Technische-Natuurkunde-HvA/inverted-pendulum-international-team-5/Visuals/presentation int 5.pdf

### INVERTED PENDULUM

INTERNATIONAL TEAM 5

### SETBACKS

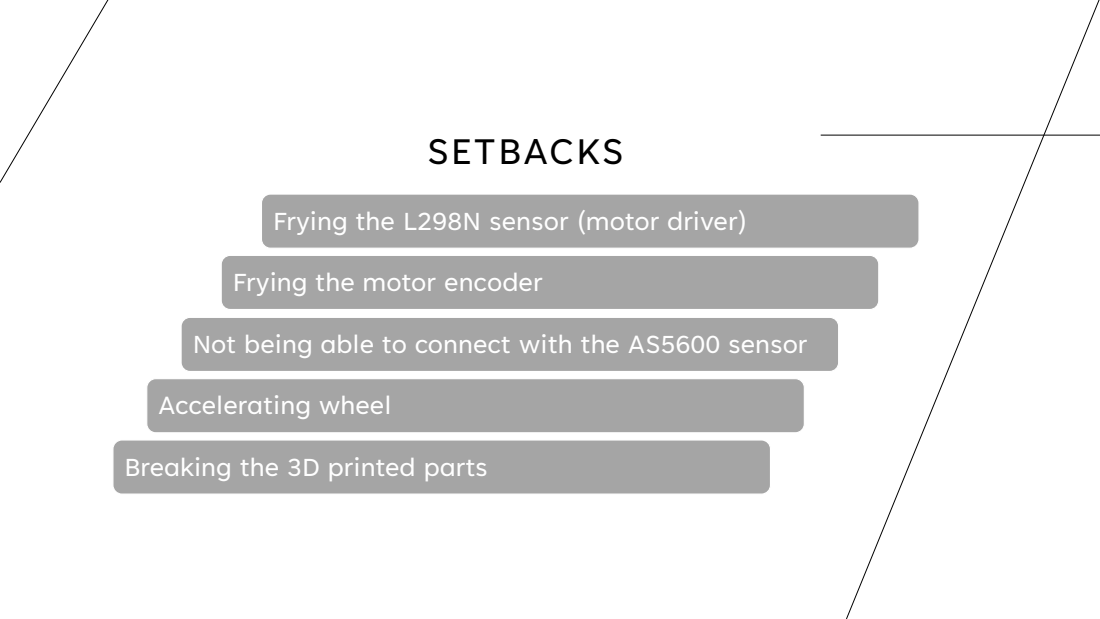
[picture p1: page 2]
Accelerating wheel

Frying the L298N sensor (motor driver)

Frying the motor encoder

Not being able to connect with the AS5600 sensor

Breaking the 3D printed parts

WORK PERFORMED

- Caracterize the motor troque–speed curve
- Implementing a code to print the angle
- Stabilising with the iron bearings
- Stabilize the pendulum with 1 PID ( angle )
- Stabilize the pendulum with a second PID ( speed )
- Printing the results

CURVES AND GRAPHS

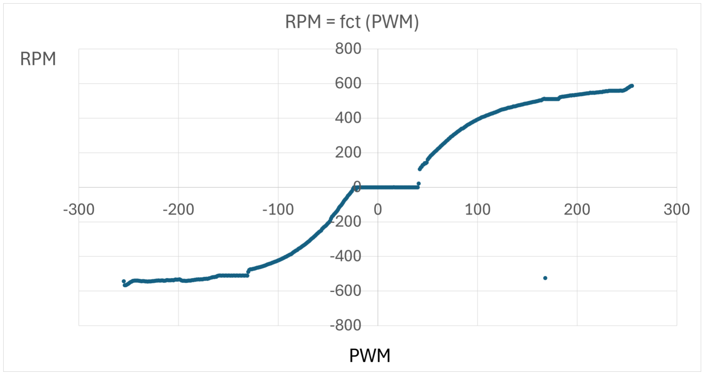
[picture p2: figure]

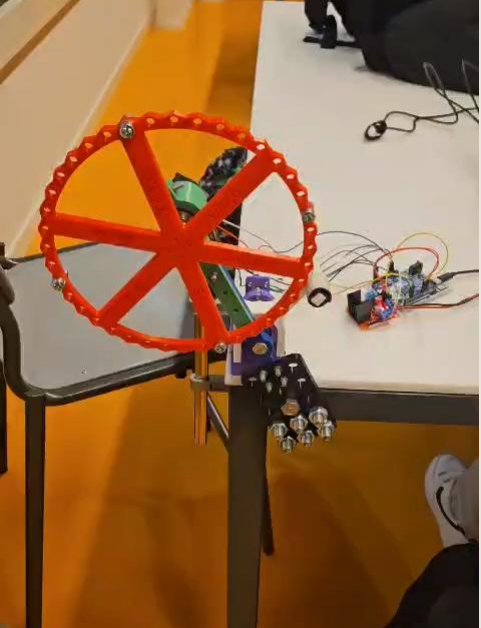
[picture p3: figure]

ACCOMPLISHMENTS

❖ Stabilised with the dummy bearings

❖ Partially stabilised with the second PID-controller and iron bearings

NEXT OBJECTIVE

Second PID to control the wheel’s speed PID tuning strategy :
- Start with P only (Ki = Kd = 0)
- Increase Kp until the response becomes fast with a small overshoot.
- If the response is too slow → increase Kp.
- Add integral action
- Increase Ki to remove steady-state error.
- If oscillations grow or the system becomes unstable → decrease Ki.
- Add derivative action
- Increase Kd to damp oscillations and reduce overshoot.
- If the control becomes noisy → decrease Kd.

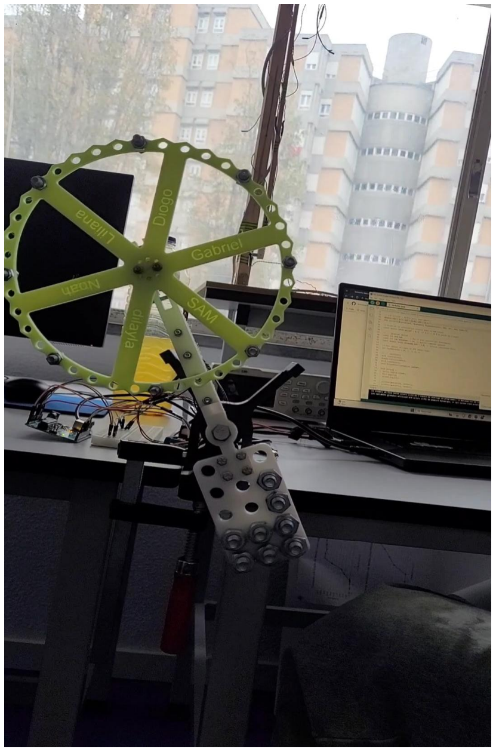
[picture p4: figure]

ACCOMPLISHMENT

- Stabilize with the iron bearings
- Regulate the speed with the second PID

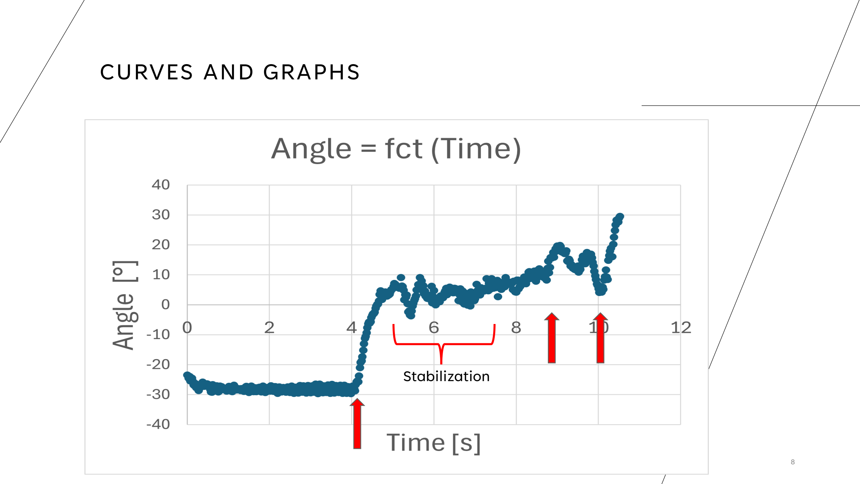
[picture p5: page 8]

CURVES AND GRAPHS

Stabilization

LIMITATIONS AND FUTURE WORK

- Structural conflict between angle and speed loops -> motor shacking
- Energy-based swing-up control

### TEAM REFLECTION
