Technische-Natuurkunde-HvA/inverted-pendulum-international-team-5/feedback/feedback-week-3.md

- Good that you uploaded a progress update. However, it does not include any code or graphs. Next time, please write your update in the markdown file called ‘weekly-progress’. Let us know if you need any help with using GitHub.
- Great job writing a Python script that visualizes the angle in real time.
- Excellent that you included several recommendations about soldering the sensor.
- Good that you improved your code to create an output-response curve. But please write all comments in English! As an international team, you should collaborate on the same code.
- The output-response curves are completely missing. In general, your repository is incomplete. We expect more from you next week.

General recommendations to all teams:
- Place your weekly progress reports in reverse order, with the most recent week at the top.
- Do not be afraid of Markdown. If you wish, you could start by writing a basic text file in Word and later convert it to Markdown.
- Always add annotations or description to all graphs, pictures, videos, code and data you share in your weekly progress report. Do not assume these are self-explanatory; your readers rely on your explanations to understand their relevance and importance.
- The weekly progress reports form the foundation of your final written product. The more clear, detailed, and comprehensive your reports are, the better prepared you will be to complete your final product.
