Technische-Natuurkunde-HvA/inverted-pendulum-international-team-5/Visuals/(PWM ; RPM) = fct(time).png

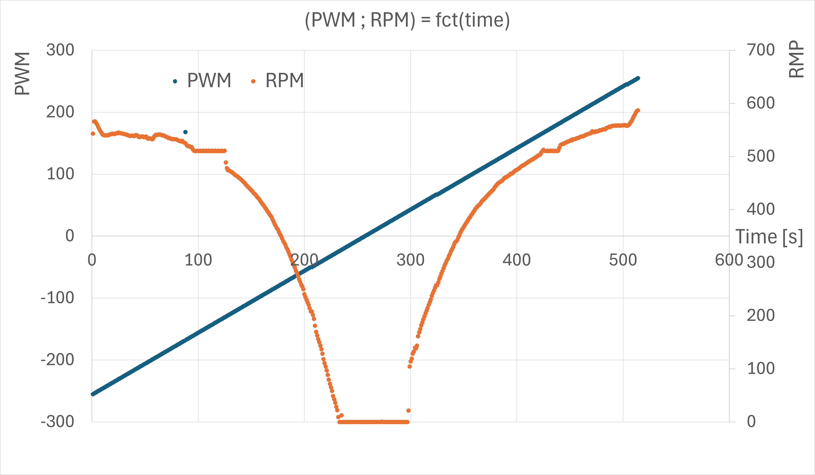
Visuals/(PWM ; RPM) = fct(time).png
