Technische-Natuurkunde-HvA/inverted-pendulum-international-team-5/Visuals/Angle = fct(Time).png

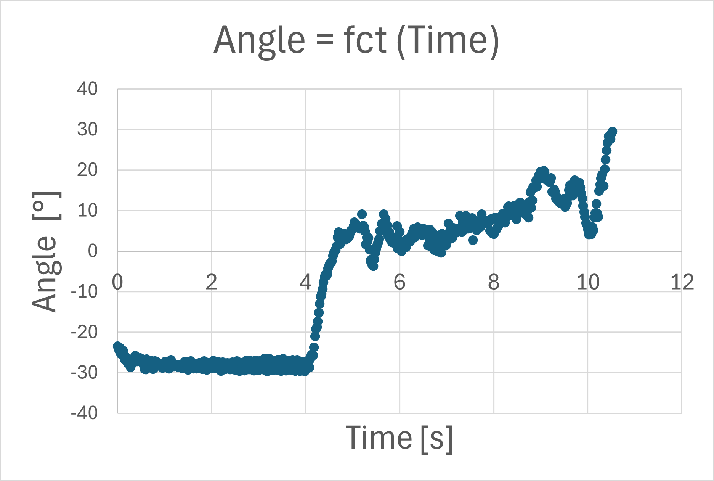
Visuals/Angle = fct(Time).png
