Technische-Natuurkunde-HvA/inverted-pendulum-international-team-5/(commit log)

2025-11-24 Add data saving functionality for AS5600 sensor
    This code initializes an AS5600 sensor and saves angle data to an SD card in CSV format, logging the time and angle.
2025-12-09 Add PID control implementation for motor control
2025-12-12 Rename (PWM ; RPM) = fct(time).png to Measured PWM and RPM against time.png
2025-12-12 Rename Measured PWM and RPM against tima.png to Measured PWM and RPM against time.png
2025-12-12 Rename RPM = fct (PWM).png to Measured RPM against PWM
2025-12-12 Add optimized cascade control for motor speed
    no work
